shannon-greenlight/PBJ-Duino/README.md

# PBJ-Duino
Synthesizer Development System for Arduino
https://www.greenfacelabs.com/pbj-duino/
