shannon-greenlight/PBJ-Duino/Filter/Design.pdf

## Filter Wizard

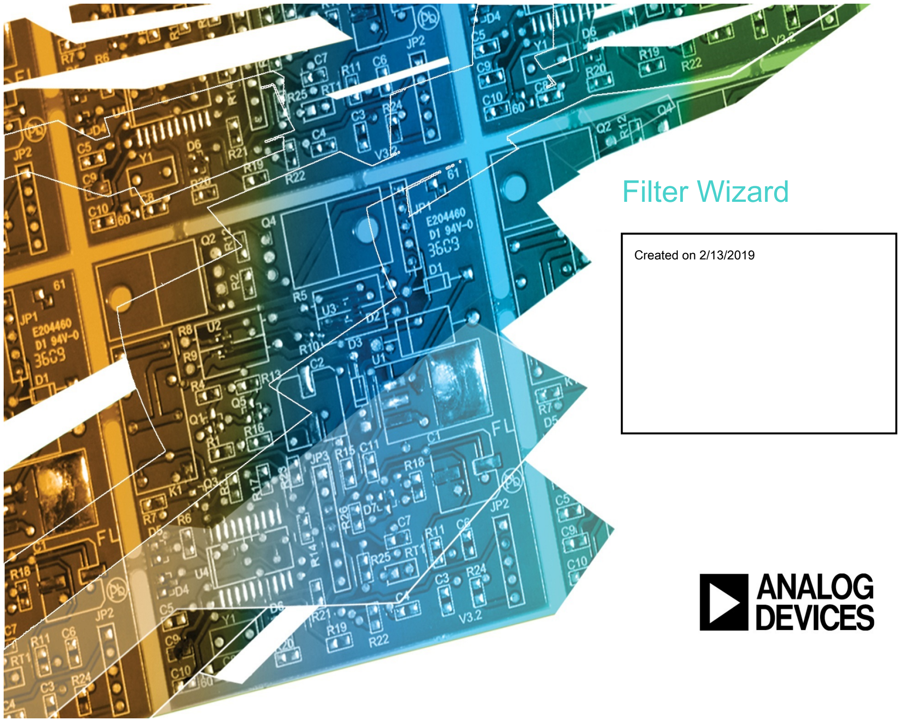
[picture p1: page 1]

Created on 2/13/2019

## Filter Wizard Design Report

Filter Requirements for Low-Pass, 3rd order Butterworth Specifications: Optimize for Specific Components, +Vs= 12, -Vs= -12 Gain: 0 dB
Passband: -3dB at 100Hz
Stopband: -40dB at 1kHz
Component Tolerances: Capacitor = 5%; Resistor = 1%; Inductor = 5%; Op Amp GBW = 20% BOM: refer to BOM.csv file

Magnitude(dB)

Magnitude(Volts per Volt)

Phase(degrees)

Phase(radians)

Group Delay

Phase Delay

Step Response

Input Impedance Magnitude

Input Impedance Phase

Noise

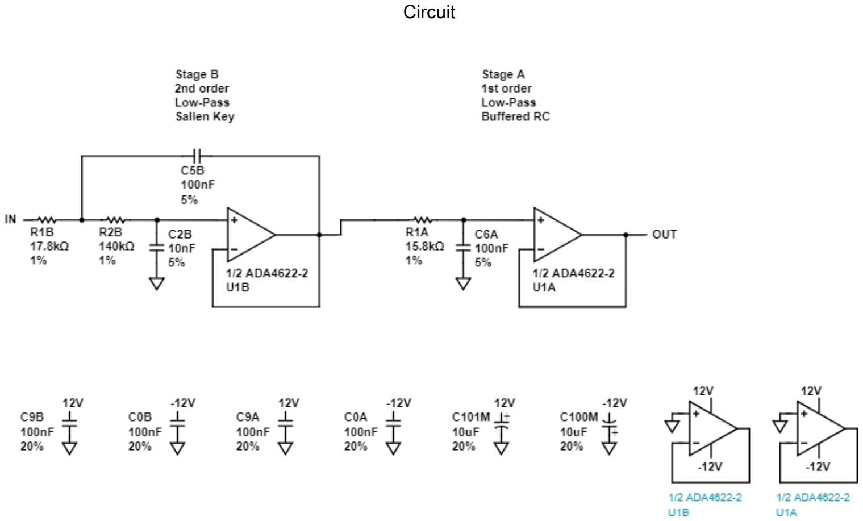
[picture p2: page 13]

Circuit
