shannon-greenlight/PBJ-Duino/circuit_1.png

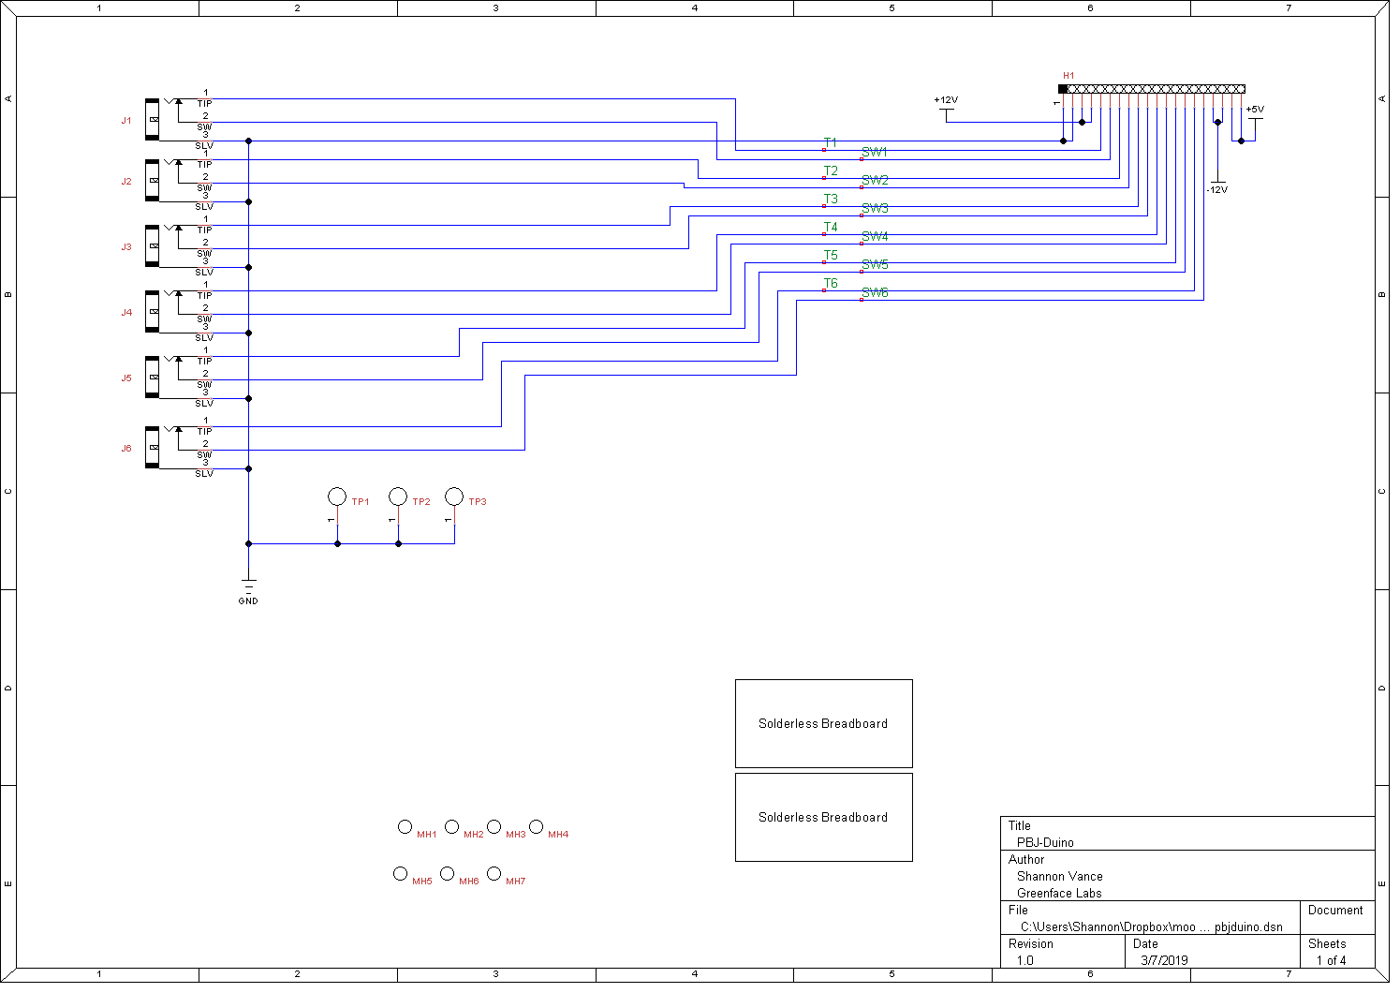
circuit_1.png
