shannon-greenlight/PBJ-Duino/circuit_2.png

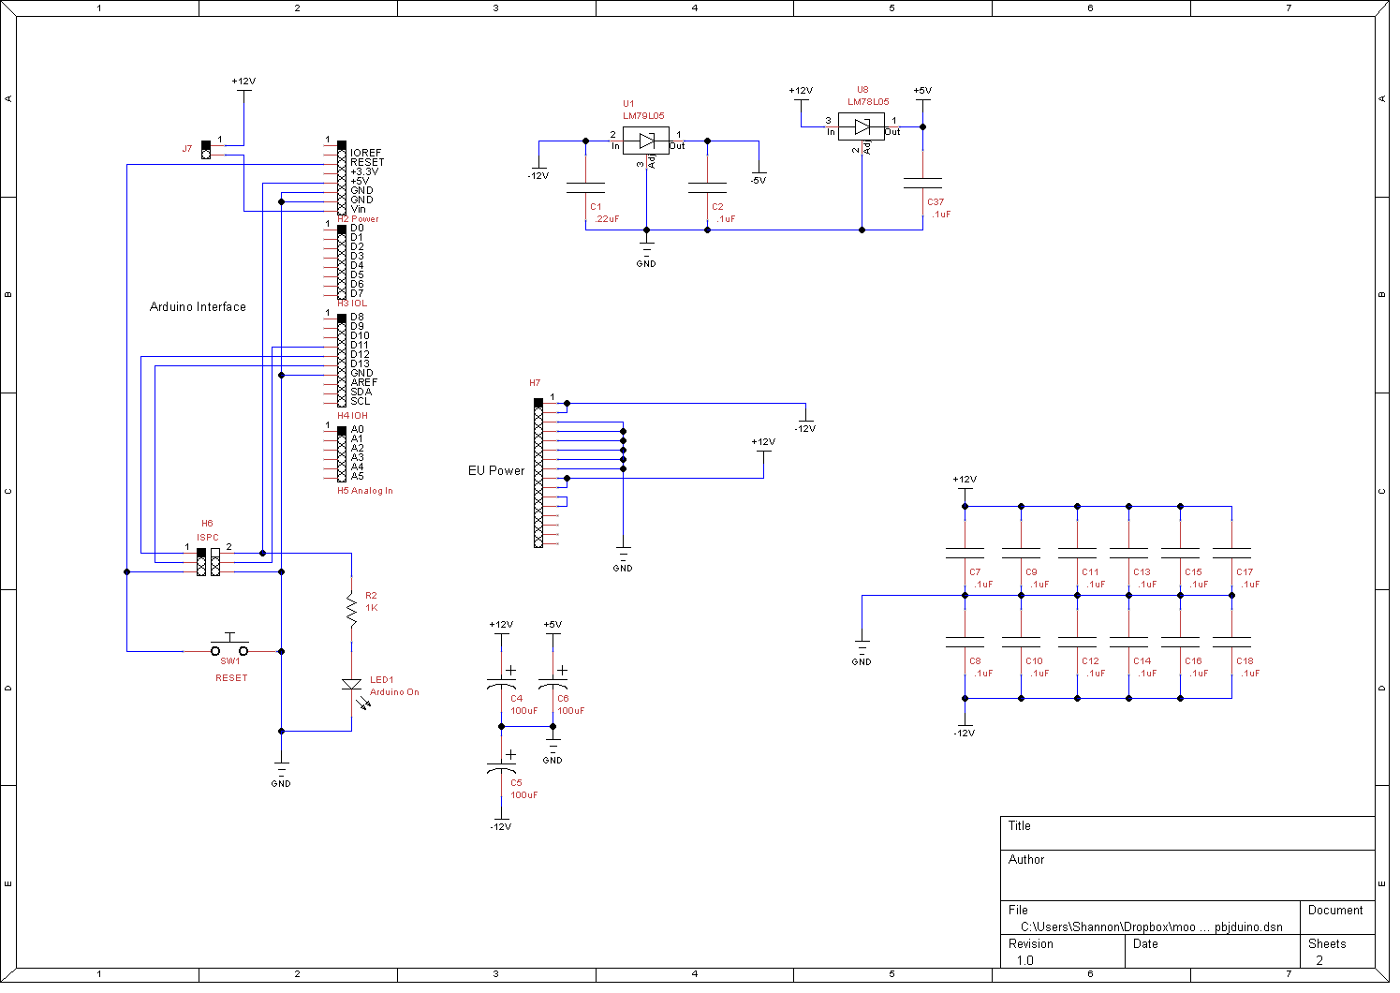
circuit_2.png
