shannon-greenlight/PBJ-Duino/circuit_3.png

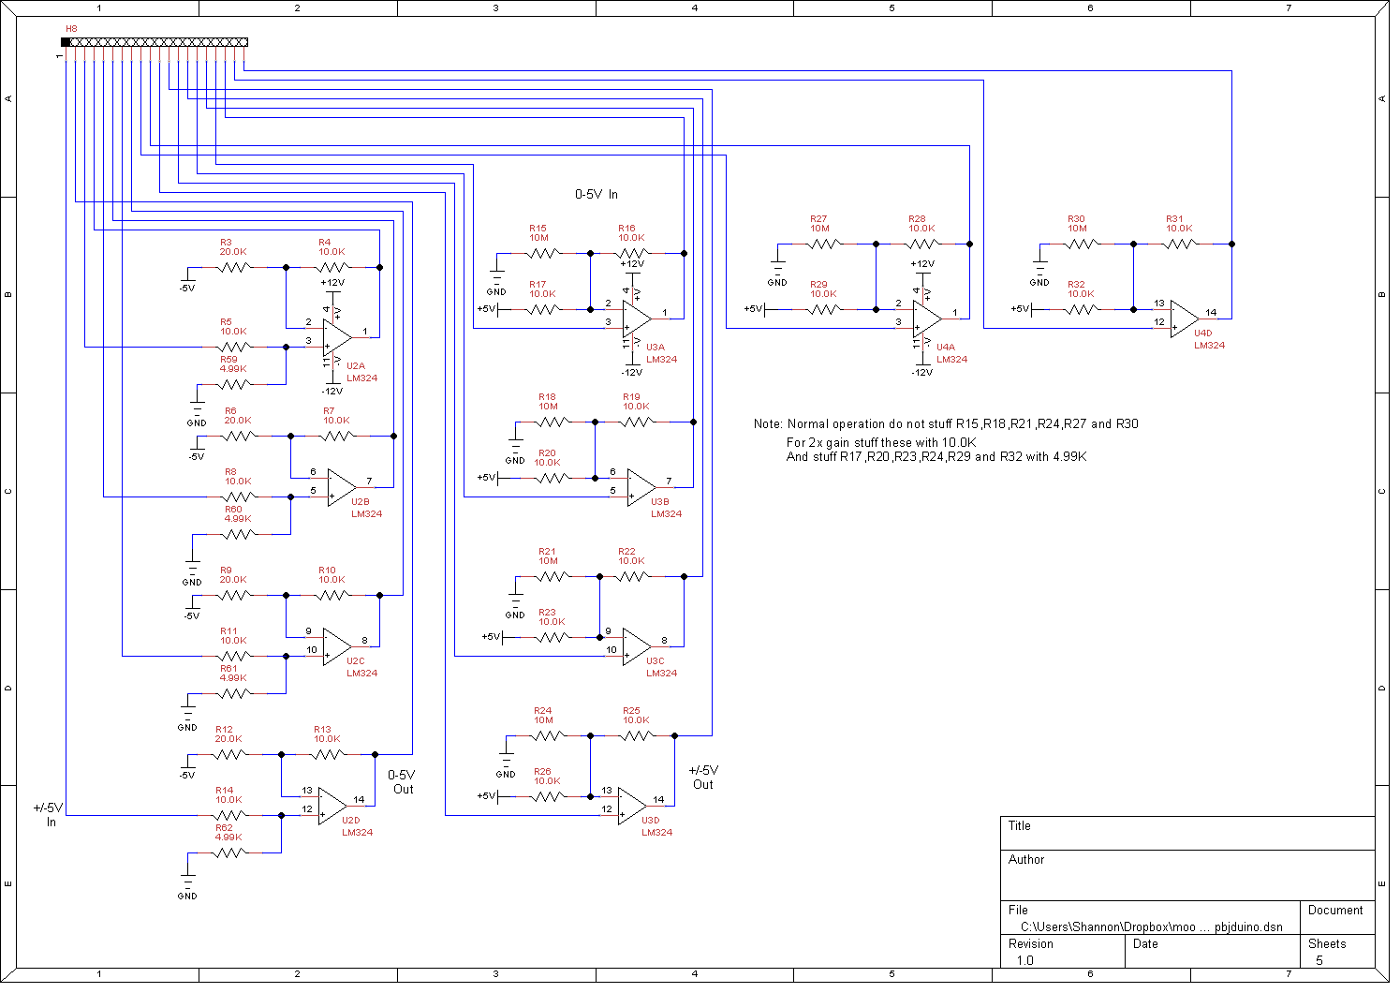
circuit_3.png
