shannon-greenlight/PBJ-Duino/circuit_4.png

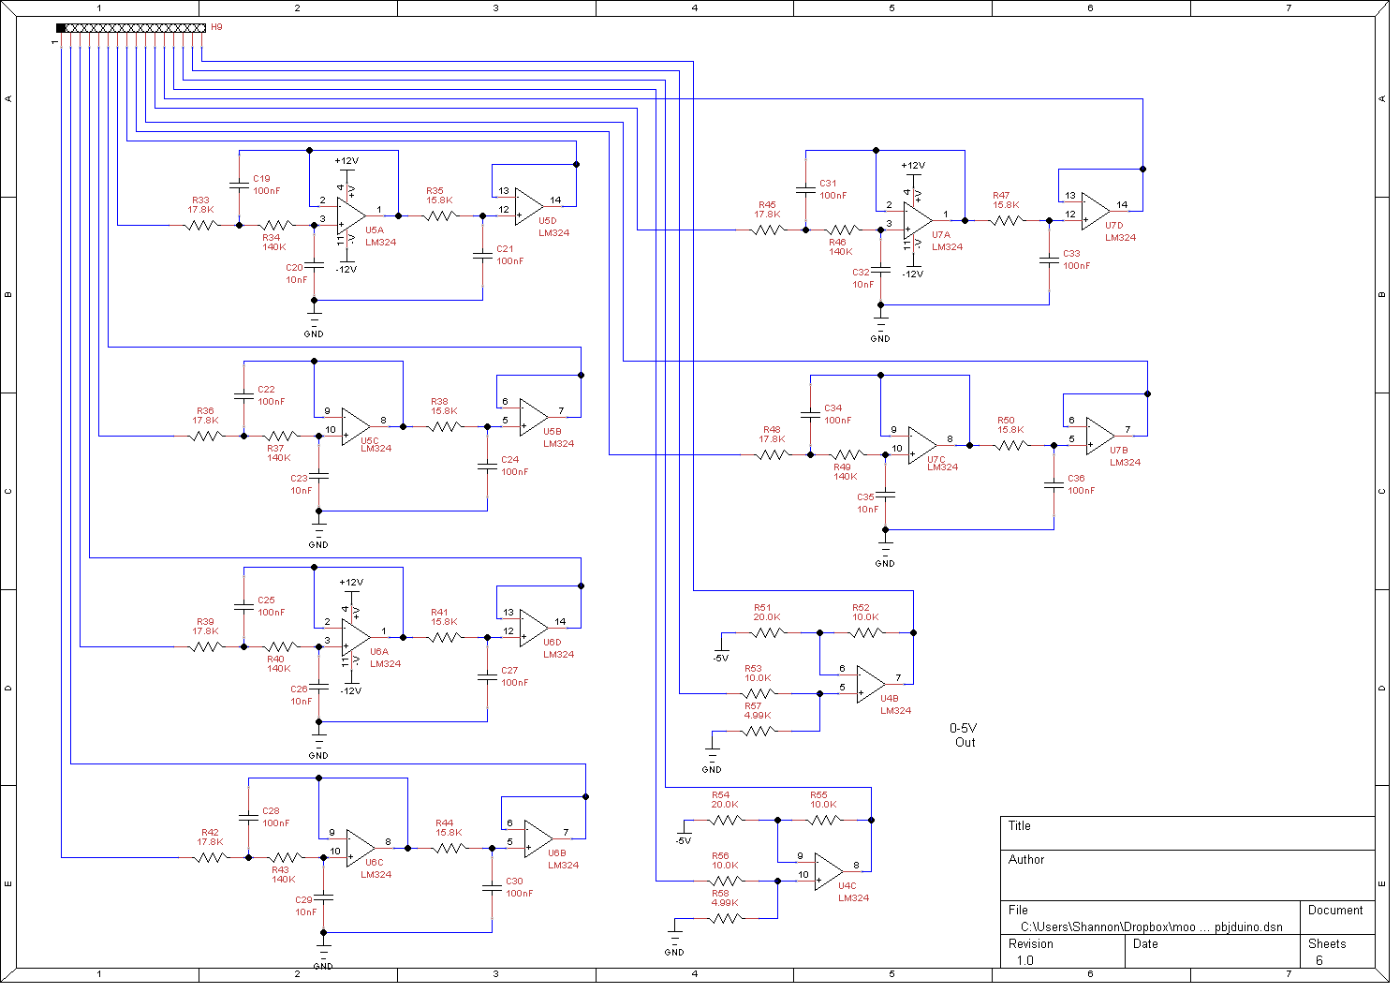
circuit_4.png
