shannon-greenlight/PBJ-Duino/Bom_pbjduino.xlsx

Manufacturer Part Number | Manufacturer | Digi-Key Part Number | Customer Reference | Reference Designator | Packaging | Part Status | Quantity | Unit Price | Extended Price | Description | RoHS Status | Lead Free Status | REACH Status
SR215C104KAA | AVX Corporation | 478-2472-ND | Capacitor | C10,C11,C12,C13,C14,C15,C16,C17,C18,C2,C7,C8,C9,C37 | Bulk | Active | 14 | 0.135 | $1.89 | CAP CER 0.1UF 50V X7R RADIAL | RoHS Compliant | Lead free | REACH Unaffected
SR215C224KAA | AVX Corporation | 478-11709-ND | Capacitor | C1 | Bag | Active | 1 | 0.41 | $0.41 | CAP CER 0.22UF 50V X7R RADIAL | RoHS Compliant | Lead free | REACH Unaffected
MRS25000C1002FCT00 | Vishay BC Components | BC3326CT-ND | Resistor | R10,R11,R13,R14,R16,R17,R19,R20,R22,R23,R25,R26,R28,R29,R31,R32,R4,R5,R52,R53,R55,R56,R7,R8 | Cut Tape (CT) | Active | 24 | 0.242 | $5.80 | RES 10K OHM 0.6W 1% AXIAL | RoHS Compliant | Lead free | Not Available
R82DC3100DQ50J | KEMET | 399-5444-1-ND | Small Capacitor | C19,C21,C22,C24,C25,C27,C28,C30,C31,C33,C34,C36 | Cut Tape (CT) | Active | 12 | 0.211 | $2.53 | CAP FILM 0.1UF 5% 63VDC RADIAL | RoHS Compliant | Lead free | REACH Unaffected
UFW1E101MED | Nichicon | 493-15125-ND | Small Electrolytic | C4,C5,C6 | Bulk | Active | 3 | 0.29 | $0.87 | CAP ALUM 100UF 20% 25V RADIAL | RoHS Compliant | Lead free | REACH Unaffected
R82EC2100DQ50J | KEMET | 399-5450-1-ND | Small Capacitor | C20,C23,C26,C29,C32,C35 | Cut Tape (CT) | Active | 6 | 0.27 | $1.62 | CAP FILM 10000PF 5% 100VDC RAD | RoHS Compliant | Lead free | REACH Unaffected
PPPC102LFBN-RC | Sullins Connector Solutions | S6106-ND | 10x2 .1 in pitch through-hole header (male or fe | H1,H8 | Tray | Active | 2 | 1.26 | $2.52 | CONN HDR 20POS 0.1 GOLD PCB | RoHS Compliant | Lead free | REACH Unaffected
MRS25000C1403FCT00 | Vishay BC Components | BC3995CT-ND | Resistor | R34,R37,R40,R43,R46,R49 | Cut Tape (CT) | Active | 6 | 0.29 | $1.74 | RES 140K OHM 0.6W 1% AXIAL | RoHS Compliant | Lead free | Not Available
MRS25000C1582FCT00 | Vishay BC Components | BC4574CT-ND | Resistor | R35,R38,R41,R44,R47,R50 | Cut Tape (CT) | Active | 6 | 0.29 | $1.74 | RES 15.8K OHM 1% 0.6W AXIAL | RoHS Compliant | Lead free | Not Available
MRS25000C1782FCT00 | Vishay BC Components | BC4022CT-ND | Resistor | R33,R36,R39,R42,R45,R48 | Cut Tape (CT) | Active | 6 | 0.29 | $1.74 | RES 17.8K OHM 0.6W 1% AXIAL | RoHS Compliant | Lead free | Not Available
CF14JT1K00 | Stackpole Electronics Inc | CF14JT1K00CT-ND | Resistor | R2 | Cut Tape (CT) | Active | 1 | 0.1 | $0.10 | RES 1K OHM 1/4W 5% AXIAL | RoHS Compliant | Lead free | REACH Unaffected
MRS25000C2002FCT00 | Vishay BC Components | BC4043CT-ND | Resistor | R12,R3,R51,R54,R6,R9 | Cut Tape (CT) | Active | 6 | 0.29 | $1.74 | RES 20K OHM 0.6W 1% AXIAL | RoHS Compliant | Lead free | Not Available
MRS25000C4991FRP00 | Vishay BC Components | PPC4.99KZCT-ND | Resistor | R57,R58,R59,R60,R61,R62 | Cut Tape (CT) | Active | 6 | 0.29 | $1.74 | RES 4.99K OHM 0.6W 1% AXIAL | RoHS Compliant | Lead free | Not Available
PPTC082LFBN-RC | Sullins Connector Solutions | S7076-ND | 8x2 .1 in pitch through-hole header (male or fem | H9 | Tray | Active | 1 | 0.99 | $0.99 | CONN HDR 16POS 0.1 TIN PCB | RoHS Compliant | Lead free | REACH Unaffected
SBH11-PBPC-D08-ST-BK | Sullins Connector Solutions | S9171-ND | 8x2 .1 in pitch through-hole header (male or fem | H7 | Tray | Active | 1 | 0.42 | $0.42 | CONN HEADER VERT 16POS 2.54MM | RoHS Compliant | Lead free | REACH Unaffected
85 | Adafruit Industries LLC | 1528-1074-ND |  | H2,H3,H4,H5,H6 | Bulk | Active | 1 | 1.95 | $1.95 | STACKING HEADER ARDUINO SHIELD | RoHS Compliant | Lead free | Not Available
151031SS04000 | Wurth Electronics Inc. | 732-5005-ND | small LED | LED1 | Bulk | Active | 1 | 0.17 | $0.17 | LED RED DIFFUSED 3MM ROUND T/H | RoHS Compliant | Lead free | REACH Unaffected
35PM2A | Switchcraft Inc. | SC1456-ND | Audio Jack 3.5mm | J1,J2,J3,J4,J5,J6 | Bulk | Active | 6 | 2.66 | $15.96 | CONN JACK MONO 3.5MM PNL MNT | RoHS Compliant | Lead free | REACH Unaffected
971110155 | Wurth Electronics Inc. | 732-13059-ND | Stud | MH5,MH6,MH7 | Bag | Active | 3 | 0.89 | $2.67 | PLASTIC SPACER STUD METRIC THREA | RoHS Compliant | Lead free | Not Available
SOF-15126 | Essentra Components | RPC5102-ND | Conical Black | MH1,MH2,MH3,MH4 | Bulk | Active | 4 | 1.43 | $5.72 | FOOT CYLINDRICAL 0.886" DIA BLK | RoHS Compliant | Lead free | REACH Unaffected
M20-9990246 | Harwin Inc. | 952-2262-ND | Single-position through-hole jumper | J7 | Bulk | Active | 1 | 0.11 | $0.11 | CONN HEADER VERT 2POS 2.54MM | RoHS Compliant | Lead free | REACH Unaffected
TL074IN | Texas Instruments | 296-7200-5-ND | Quad Op-Amp | U2,U3,U4,U5,U6,U7 | Tube | Active | 6 | 0.98 | $5.88 | IC OPAMP JFET 4 CIRCUIT 14DIP | RoHS Compliant | Lead free | REACH Unaffected
LM78L05ACZ/NOPB | Texas Instruments | LM78L05ACZNS/NOPB-ND | +5V 1A Regulator | U8 | Box | Active | 1 | 0.67 | $0.67 | IC REG LINEAR 5V 100MA TO92-3 | RoHS Compliant | Lead free | REACH Unaffected
MC79L05ACPG | ON Semiconductor | MC79L05ACPGOS-ND | -5V 1A Regulator | U1 | Bag | Active | 1 | 0.43 | $0.43 | IC REG LINEAR -5V 100MA TO92-3 | RoHS Compliant | Lead free | REACH Unaffected
GS-830 | Global Specialties | BKGS-830-ND | Solderless Breadboard | A1,A2 | Bulk | Active | 2 | 8.25 | $16.50 | BREADBRD TERM STRIP 6.50X2.13" | RoHS Compliant | Lead free | Not Available
1825910-6 | TE Connectivity ALCOSWITCH Switches | 450-1650-ND |  | SW1 | Bulk | Active | 1 | 0.1 | $0.10 | SWITCH TACTILE SPST-NO 0.05A 24V | RoHS Compliant | Lead free | Not Available
5006 | Keystone Electronics | 36-5006-ND | Through-hole low-profile compact test point | TP1,TP2,TP3 | Bulk | Active | 3 | 0.35 | $1.05 | PC TEST POINT COMPACT BLACK | RoHS Compliant | Lead free | REACH Unaffected
AR 14 HZL-TT | Assmann WSW Components | AE10012-ND | 14 Pin socket | S1,S2,S3,S4,S5,S6 | Tube | Active | 6 | 0.79 | $4.74 | CONN IC DIP SOCKET 14POS TIN | RoHS Compliant | Lead free | REACH Unaffected
29331 | Keystone Electronics | 36-29331-ND |  | SC1,SC2,SC3 | Bulk | Active | 3 | 0.21 | $0.63 | MACH SCREW PAN SLOTTED M2.5X0.45 | RoHS Compliant | Lead free | REACH Unaffected
4687 | Keystone Electronics | 36-4687-ND |  | N1,N2,N3 | Bulk | Active | 3 | 0.15 | $0.45 | HEX NUT 0.197" NYLON M2.5 | RoHS Compliant | Lead free | REACH Unaffected
