shannon-greenlight/PBJ-Duino/(commit log)

2019-03-09 Removed Gerber files
2019-03-19 Changed name of filter pdf.
2019-03-19 Updated csv.
    [Bom_pbj_duino.csv]
2019-04-09 Adds neat stuff
    [BOM.csv, Group Delay.csv, Input Impedance Magnitude.csv, Input Impedance Phase.csv, Magnitude(Volts per Volt).csv, Magnitude(dB).csv, Noise.csv, Phase Delay.csv]
2019-04-09 removed filterdesign file
2019-05-26 Fixed Reset button
2019-06-09 More fixes.
    [Bom_pbj_duino.csv, Bom_pbjduino.xlsx, pbjduino.xlsx]
